janscience/EOD-Logger/eodlogger_4channel_sensors/images/eodlogger-teensy3.5-pinout.pdf

# RTC

# Sensors

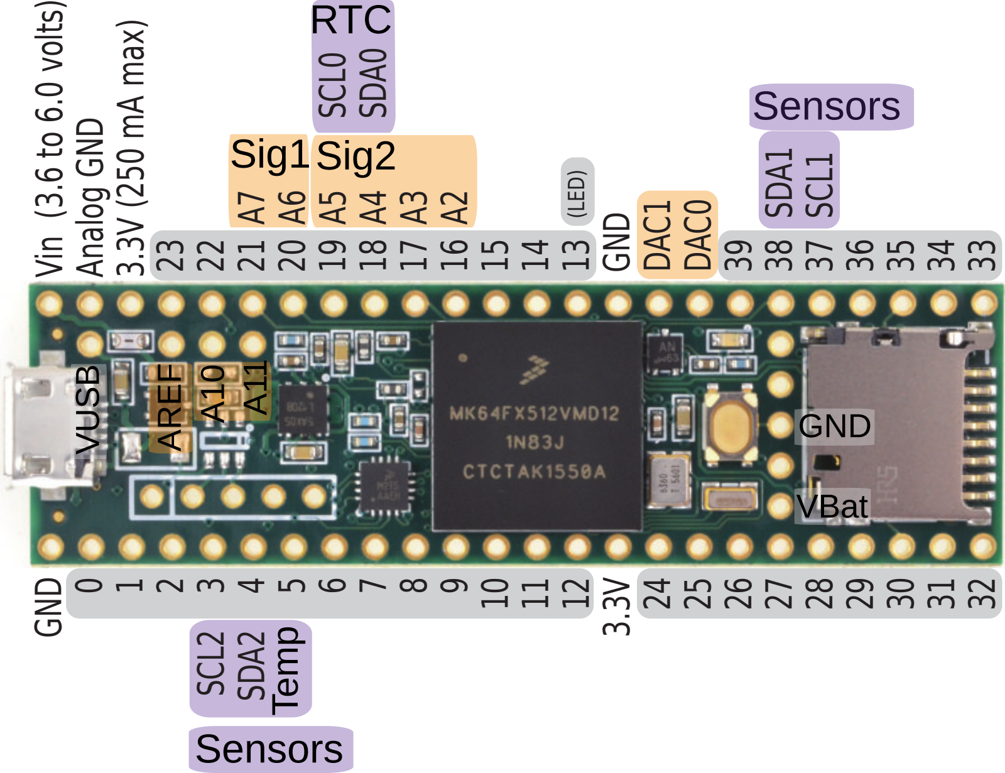
[picture p4: page 1]

### GND

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
3.3V

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
### GND

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
(LED)

# Vin (3.6 to 6.0 volts)

# Analog GND

# 3.3V (250 mA max)

SCL2
SDA2

DAC1

DAC0

SCL0

SDA0

# Sensors

SDA1
SCL1

# Temp

# Sig1Sig2

A10

A11

# AREF

# VBat

# GND

# VUSB
