janscience/EOD-Logger/(commit log)

2022-04-05 [eodlogger_2channel_wave] update to changes in TeeRec
    [logger.cfg]
2022-04-18 improved error message for writing data
    [eodlogger_2channel_wave.ino]
2022-04-20 improved error handling of file issues
    [eodlogger_2channel_wave.ino]
2022-06-06 new 4channel logger with sensors
    [logger.cfg]
2022-06-27 added initial delay
    [logger.cfg]
2022-06-27 updated docs
    [logger.cfg]
2022-06-27 updated configs
    [logger.cfg]
2022-06-28 [2channel_wave] update for Teensy_Amp R3.0
2022-06-28 [4channel_sensors] update for Teensy_Amp R3.0
2022-12-27 renamed ContinuousADC to TeensyADC
2022-12-28 update to TeensyADCSettings
2022-12-28 fixed use of TeensyADCSettings
    [eodlogger_2channel_wave.ino, eodlogger_4channel_sensors.ino]
